UAH-CRW/deploymentboard/README.md

# deploymentboard
Deployment electronics design
