UAH-CRW/deploymentboard/Solenoid extension comparison.PNG

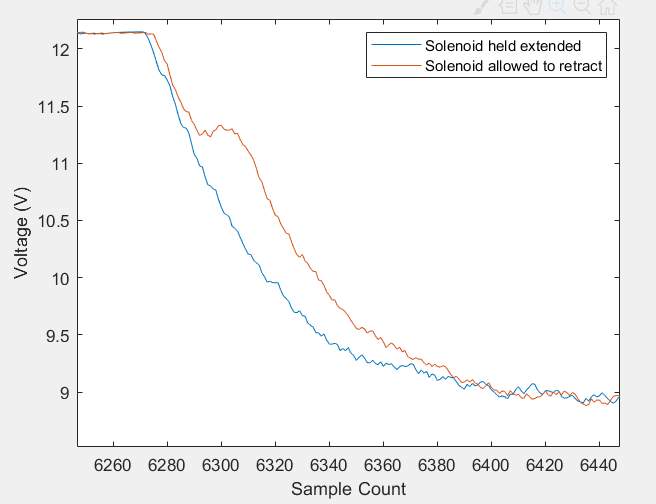
Solenoid extension comparison.PNG
