UAH-CRW/deploymentboard/board/Deployment Board Order Rev2.xlsx

Purchase Order Check List
Date: | 2019-02-14 |  | Vendor: | Digikey
Requestor: | Daniel Corey |  | Contact: | N/A
Account: |  |  | Address: | N/A
Phone (Requestor): | 571-275-3697
Email (Requestor): | dc0069@uah.edu |  | Phone (Vendor): | N/A
 |  |  | Fax (Vendor): | N/A
Quote Attached | ( )
Quote #: |  | Items over $7,500 must be bid out.
Quantity | Part Number | Description and Research Justification |  |  | Unit Price | Total
6 | ED10561-ND | TERM BLK 2P SIDE ENT 2.54MM PCB |  |  | $0.94 | $5.64 | https://www.digikey.com/short/p3rv30 | All components can also be found in the digikey cart linked to the left
3 | 1655-1530-1-ND | DIODE GEN PURP 600V 5A SMB |  |  | $0.53 | $1.59
2 | 563-1003-1-ND | SWITCH SLIDE DIP SPST 100MA 6V |  |  | $1.07 | $2.14
6 | S5902-10-ND | CONN HDR 10POS 0.079 GOLD SMD |  |  | $1.24 | $7.44
4 | 478-1171-1-ND | CAP CER 47PF 50V C0G/NP0 0603 |  |  | $0.10 | $0.40
10 | A130087CT-ND | CRGCQ 0603 220R 5% |  |  | $0.02 | $0.23
16 | SSM3K339RLFCT-ND | MOSFET N-CH 40V 2A SOT-23F |  |  | $0.37 | $5.94
3 | 668-1470-ND | AUDIO MAGNETIC XDCR 3-7V TH |  |  | $0.60 | $1.80
10 | 1276-1784-1-ND | CAP CER 4.7UF 16V X5R 0603 |  |  | $0.21 | $2.10
4 | 311-1060-1-ND | CAP CER 15PF 50V C0G/NPO 0603 |  |  | $0.10 | $0.40
12 | 1276-6524-1-ND | CAP CER 1UF 16V X7R 0603 |  |  | $0.04 | $0.52
4 | 1276-7076-1-ND | CAP CER 22UF 16V X5R 0603 |  |  | $0.87 | $3.48
6 | 641-1698-1-ND | DIODE SCHOTTKY 40V 2A DO214AC |  |  | $0.53 | $3.18
4 | 587-2421-1-ND | FIXED IND 10UH 540MA 133 MOHM |  |  | $0.21 | $0.84
4 | 490-10594-1-ND | FIXED IND 4.7UH 1.4A 180 MOHM |  |  | $0.45 | $1.80
4 | 445-16534-1-ND | FIXED IND 27NH 450MA 220 MOHM |  |  | $0.28 | $1.12
4 | 511-1578-1-ND | LED GREEN DIFFUSED 0603 SMD |  |  | $0.34 | $1.36
4 | 511-1301-1-ND | LED RED CLEAR 0603 SMD |  |  | $0.41 | $1.64
4 | P49.9KDBCT-ND | RES SMD 49.9KOHM 0.1% 1/10W 0603 |  |  | $0.35 | $1.40
10 | 311-432KHRCT-ND | RES SMD 432K OHM 1% 1/10W 0603 |  |  | $0.02 | $0.24
10 | 311-47KGRCT-ND | RES SMD 47K OHM 5% 1/10W 0603 |  |  | $0.02 | $0.20
5 | 296-27024-1-ND | IC REG BCK 3.3V 0.8A SYNC 10MSOP |  |  | $1.93 | $9.65
6 | 36-1051-ND | BATTERY HOLDER CR123A PC PIN |  |  | $1.55 | $9.30
3 | SC4503TSKCT-ND | IC REG BOOST ADJ 1.4A TSOT23-5 |  |  | $1.88 | $5.64
4 | ATXMEGA32A4U-AURCT-ND | IC MCU 8/16BIT 32KB FLASH 44TQFP |  |  | $3.02 | $12.08
4 | EG4544-ND | SWITCH SNAP ACTION SPDT 5A 125V |  |  | $1.23 | $4.92
36 | RR08P10.0KDCT-ND | RES SMD 10K OHM 0.5% 1/16W 0603 |  |  | $0.10 | $3.60
28 | 399-1100-1-ND | CAP CER 0.1UF 25V Y5V 0603 |  |  | $0.04 | $1.01
12 | WM3443-ND | CONN HEADER VERT 2POS 2MM |  |  | $0.34 | $4.03
15 | WM4388-ND | CONN RCPT 2CKT 2MM WTB |  |  | $0.18 | $2.77
50 | WM3454CT-ND | CONN SOCKET 22-28AWG CRIMP TIN |  |  | $0.06 | $2.97
12 | 587-3238-1-ND | CAP CER 10UF 16V X5R 0603 |  |  | $0.32 | $3.82
4 | S9015E-03-ND | CONN HEADER VERT 6POS 1.27MM |  |  | $0.48 | $1.92
5 | DMG2305UX-13DICT-ND | MOSFET P-CH 20V 4.2A SOT23 |  |  | $0.45 | $2.25
12 | 565-4315-ND‎ | CAP ALUM POLY 2200UF 20% 16V T/H |  |  | $1.17 | $14.00
3 | 160-1969-ND‎ | LED RED DIFFUSED T-1 3/4 T/H |  |  | $0.36 | $1.08
3 | CF14JT1K00CT-ND‎ | RES 1K OHM 1/4W 5% AXIAL |  |  | $0.10 | $0.30
2 | 1568-1592-ND‎ | SOLENOID PUSH INTERMITTENT 5V |  |  | $4.95 | $9.90
 |  | Total Price: |  |  |  | $132.70
Daniel Corey
Requestor |  |  | P.I. Appoval
 |  |  | Date
Office Use Only
Requisition #: |  |  | Date:
Purchase Order #: |  |  | Date:
Delivery Date:
Attach backup matter to this form. |  |  |  |  | Rev. 03
