UAH-CRW/deploymentboard/board/BOM with links.xlsx

Id | Designator | Package | Quantity | Designation | Supplier and ref
1 | J1,J3 | 2 pin 2.54mm screw terminal OSTVN02A150 | 2 | Screw_Terminal_01x02 | https://www.digikey.com/product-detail/en/on-shore-technology-inc/OSTVN02A150/ED10561-ND/1588862
2 | C20,C19,C3,C2,C1,C15,C13 | C_0603_1608Metric_Pad1.05x0.95mm_HandSolder | 7 | 100nF | https://www.digikey.com/product-detail/en/samsung-electro-mechanics/CL10B104KO8NNNC/1276-1005-1-ND/3889091
3 | J6 | JST_PH_B2B-PH-K_1x02_P2.00mm_Vertical | 1 | Conn_01x02_Male | https://www.digikey.com/product-detail/en/jst-sales-america-inc/B2B-PH-K-S-LF-SN/455-1704-ND/926611
4 | D4 | D_SMB_Handsoldering | 1 | D_Small | https://www.digikey.com/product-detail/en/smc-diode-solutions/SD560BTR/1655-1530-1-ND/6022975
5 | R17,R14,R7,R13,R6,R4,R2,R1,R5,R10 | R_0603_1608Metric_Pad1.05x0.95mm_HandSolder | 9 | 10k | https://www.digikey.com/product-detail/en/susumu/RR0816P-103-D/RR08P10.0KDCT-ND/432748
6 | SW3 | DIP Switch CHS-01TA | 1 | SW_DIP_x01 | https://www.digikey.com/product-detail/en/nidec-copal-electronics/CHS-01TA/563-1003-2-ND/948314
7 | SW2 | JST_PH_B2B-PH-K_1x02_P2.00mm_Vertical | 1 | SW_SPDT | https://www.digikey.com/product-detail/en/jst-sales-america-inc/B2B-PH-K-S-LF-SN/455-1704-ND/926611
8 | U1 | XBee_SMD | 2 | XBee | https://www.digikey.com/product-detail/en/sullins-connector-solutions/NPPN101BFLD-RC/S5902-10-ND/810025
9 | C17,C18,C7 | C_0603_1608Metric_Pad1.05x0.95mm_HandSolder | 3 | 47pF | https://www.digikey.com/product-detail/en/avx-corporation/06035A470JAT2A/478-1171-1-ND/564203
10 | R15,R16 | R_0603_1608Metric_Pad1.05x0.95mm_HandSolder | 2 | 220 | https://www.digikey.com/product-detail/en/panasonic-electronic-components/ERJ-3EKF22R0V/P22.0HCT-ND/1746745
11 | Q4,Q1,Q2,Q3 | NFET Toshiba SSM3K339R | 4 | Q_NJFET_GSD | https://www.digikey.com/product-detail/en/toshiba-semiconductor-and-storage/SSM3K339RLF/SSM3K339RLFCT-ND/4781038
12 | J5 | PinHeader_2x03_P1.27mm_Vertical | 1 | Conn_02x03_Odd_Even | https://www.digikey.com/product-detail/en/sullins-connector-solutions/GRPB032MWCN-RC/S9017E-03-ND/1786480
13 | BZ1 | Buzzer_12x9.5RM7.6 | 1 | Buzzer | https://www.digikey.com/product-detail/en/pui-audio-inc/AT-1224-TWT-5V-2-R/668-1470-ND/5011404
14 | C10,C8,C5 | C_0603_1608Metric_Pad1.05x0.95mm_HandSolder | 3 | 10uF | https://www.digikey.com/product-detail/en/samsung-electro-mechanics/CL10A106MA8NRNC/1276-1869-1-ND/3889955
15 | C4,C16 | C_0603_1608Metric_Pad1.05x0.95mm_HandSolder | 2 | 4.7uF | https://www.digikey.com/product-detail/en/samsung-electro-mechanics/CL10A475KO8NNNC/1276-1784-1-ND/3889870
16 | C14 | C_0603_1608Metric_Pad1.05x0.95mm_HandSolder | 1 | 15pF | https://www.digikey.com/product-detail/en/yageo/CC0603JRNPO9BN150/311-1060-1-ND/302970
17 | C12 | C_0603_1608Metric_Pad1.05x0.95mm_HandSolder | 1 | 1uF | https://www.digikey.com/product-detail/en/samsung-electro-mechanics/CL10B105MO8NNWC/1276-6524-1-ND/5961383
18 | C11,C6 | C_0603_1608Metric_Pad1.05x0.95mm_HandSolder | 2 | 1uF | https://www.digikey.com/product-detail/en/samsung-electro-mechanics/CL10B105MO8NNWC/1276-6524-1-ND/5961383
19 | C9 | C_0603_1608Metric_Pad1.05x0.95mm_HandSolder | 1 | 22uF | https://www.digikey.com/product-detail/en/samsung-electro-mechanics/CL10A226MO7JZNC/1276-7076-1-ND/7320718
20 | SW1 | JST_EH_B03B-EH-A_1x03_P2.50mm_Vertical | 1 | SW_SPDT | https://www.digikey.com/product-detail/en/jst-sales-america-inc/B3B-PH-K-S-LF-SN/455-1705-ND/926612
21 | J2 | USB_Micro-B_Amphenol_10103594-0001LF_Horizontal | 1 | USB_B_Micro | https://www.digikey.com/product-detail/en/molex-llc/1051640001/WM11263CT-ND/5287250
22 | D3 | D_SOD-323 | 1 | D | https://www.digikey.com/product-detail/en/vishay-semiconductor-diodes-division/10BQ015/10BQ015-ND/351865
23 | L1 | L_1210_3225Metric_Pad1.42x2.65mm_HandSolder | 1 | 10uH | https://www.digikey.com/product-detail/en/taiyo-yuden/LBC3225T100KR/587-2421-1-ND/2230287
24 | L2 | L_1210_3225Metric_Pad1.42x2.65mm_HandSolder | 1 | 4.7uH | https://www.digikey.com/product-detail/en/murata-electronics-north-america/1277AS-H-4R7M=P2/490-10594-2-ND/5247205
25 | L3 | L_1210_3225Metric_Pad1.42x2.65mm_HandSolder | 1 | 27nH | https://www.digikey.com/product-detail/en/tdk-corporation/NLV32T-027J-EF/445-16534-1-ND/4766575
26 | D1 | LED_0603_1608Metric_Pad1.05x0.95mm_HandSolder | 1 | LED - green | https://www.digikey.com/product-detail/en/rohm-semiconductor/SML-D12M8WT86/511-1578-1-ND/1641810
27 | D2 | LED_0603_1608Metric_Pad1.05x0.95mm_HandSolder | 1 | LED - red | https://www.digikey.com/product-detail/en/rohm-semiconductor/SML-310VTT86/511-1301-1-ND/637114
28 | U3 | SSOP-16_3.9x4.9mm_P0.635mm | 1 | FT230XS | https://www.digikey.com/product-detail/en/ftdi-future-technology-devices-international-ltd/FT230XS-R/768-1135-1-ND/3029155
29 | R12 | R_0603_1608Metric_Pad1.05x0.95mm_HandSolder | 1 | 49.9k | https://www.digikey.com/product-detail/en/panasonic-electronic-components/ERA-3AEB4992V/P49.9KDBCT-ND/3075986
30 | R11 | R_0603_1608Metric_Pad1.05x0.95mm_HandSolder | 1 | 432k | https://www.digikey.com/product-detail/en/yageo/RC0603FR-07432KL/311-432KHRCT-ND/730186
31 | R9,R8 | R_0603_1608Metric_Pad1.05x0.95mm_HandSolder | 2 | 27 | https://www.digikey.com/product-detail/en/rohm-semiconductor/ESR03EZPJ270/RHM27DCT-ND/4053754
32 | R3 | R_0603_1608Metric_Pad1.05x0.95mm_HandSolder | 1 | 47k | https://www.digikey.com/product-detail/en/yageo/RC0603JR-0747KL/311-47KGRCT-ND/729741
33 | U4 | 10-pin FP TPS62056DGSR | 1 | IC_REG_BCK_3.3V | https://www.digikey.com/product-detail/en/texas-instruments/TPS62056DGSR/296-27024-1-ND/2255304
34 | BT1,BT2 | CR123A Battery Holder | 2 | Battery | https://www.digikey.com/product-detail/en/keystone-electronics/1051/36-1051-ND/3465420
35 | U5 | IC REG BOOST SC4503TSKTRT | 1 | IC_REG_BOOST_ADJ_1.4A | https://www.digikey.com/product-detail/en/semtech-corporation/SC4503TSKTRT/SC4503TSKCT-ND/1249536
36 | U2 | TQFP-44_10x10mm_P0.8mm | 1 | ATxmega128A4U-AU | https://www.digikey.com/product-detail/en/microchip-technology/ATXMEGA32A4U-AUR/ATXMEGA32A4U-AURCT-ND/3903783
 |  |  |  | Actual arming switch | https://www.digikey.com/product-detail/en/omron-electronics-inc-emc-div/D3V-162-1C5/D3V-162-1C5-ND/2754900
 |  |  |  | Actual latch state switch | https://www.digikey.com/product-detail/en/e-switch/MS0850503F010S1A/EG4544-ND/1628281
 | JST Connectors on cable (01x02) |  |  |  | https://www.amazon.com/Shappy-Pieces-Connector-Silicone-Female/dp/B07449V33P
 | JST connectors on cable (01x03) |  |  |  | https://www.amazon.com/Micro-Connector-150mm-Cable-Female/dp/B01DUC1PW6
