UAH-CRW/deploymentboard/board/board.kicad_pcb

## KiCad design board/board.kicad_pcb (2019-03-03)

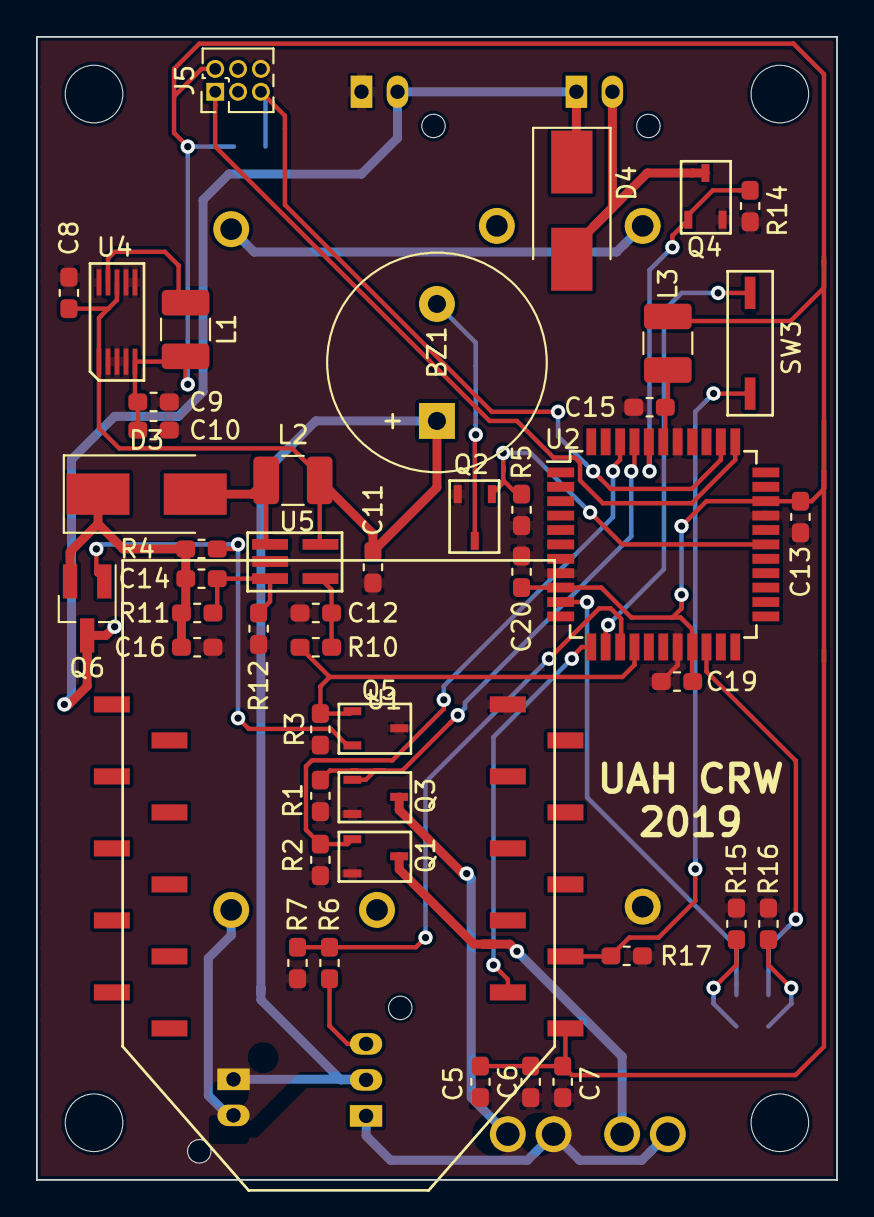
[picture p2: board board.kicad_pcb from above]

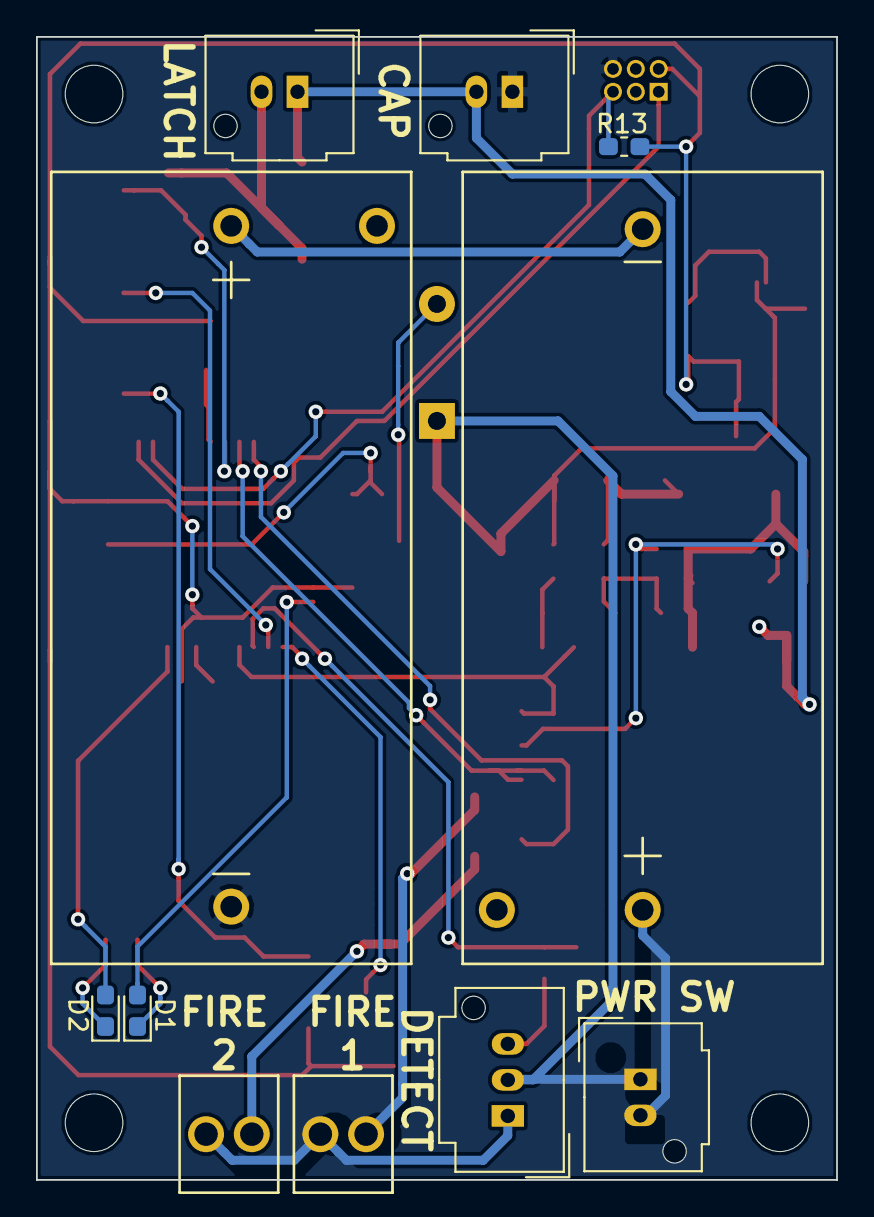
[picture p3: board board.kicad_pcb from below]

Board: 2 copper layers, 44.4 x 63.5 mm, 61 parts (11 on the bottom side), 34 nets.

Parts:
BT1, BT2: Battery; CR123A Battery Holder
BZ1: Buzzer; Buzzer_12x9.5RM7.6
C5, C8, C10: 10uF; C_0603_1608Metric_Pad1.05x0.95mm_HandSolder
C6, C11, C12: 1uF; C_0603_1608Metric_Pad1.05x0.95mm_HandSolder
C7: 47pF; C_0603_1608Metric_Pad1.05x0.95mm_HandSolder
C9: 22uF; C_0603_1608Metric_Pad1.05x0.95mm_HandSolder
C13, C15, C19, C20: 100nF; C_0603_1608Metric_Pad1.05x0.95mm_HandSolder
C14: 15pF; C_0603_1608Metric_Pad1.05x0.95mm_HandSolder
C16: 4.7uF; C_0603_1608Metric_Pad1.05x0.95mm_HandSolder
D1, D2: LED; LED_0603_1608Metric_Pad1.05x0.95mm_HandSolder
D3: D; D_SMB_Handsoldering
D4: D_Small; D_SMB_Handsoldering
J1, J3: Screw_Terminal_01x02; 2 pin 2.54mm screw terminal OSTVN02A150
J4, J6: Conn_01x02_Male; Molex_MicroClasp_55932-0210_1x02_P2.00mm_Vertical
J5: Conn_02x03_Odd_Even; PinHeader_2x03_P1.27mm_Vertical
L1: 10uH; L_1210_3225Metric_Pad1.42x2.65mm_HandSolder
L2: 4.7uH; L_1210_3225Metric_Pad1.42x2.65mm_HandSolder
L3: 27nH; L_1210_3225Metric_Pad1.42x2.65mm_HandSolder
MH1, MH2, MH3, MH4: MountingHole; MountingHole_3.2mm_M3
Q1, Q2, Q3, Q4, Q5: Q_NJFET_GSD; NFET Toshiba SSM3K339R
Q6: Q_PJFET_GSD; SOT-23_Handsoldering
R1, R2, R4, R5, R6, R7, R10, R13, R14, R17: 10k; R_0603_1608Metric_Pad1.05x0.95mm_HandSolder
R3: 10K; R_0603_1608Metric_Pad1.05x0.95mm_HandSolder
R11: 432k; R_0603_1608Metric_Pad1.05x0.95mm_HandSolder
R12: 49.9k; R_0603_1608Metric_Pad1.05x0.95mm_HandSolder
R15, R16: 220; R_0603_1608Metric_Pad1.05x0.95mm_HandSolder
SW1: SW_SPDT; Molex_MicroClasp_55932-0310_1x03_P2.00mm_Vertical
SW2: SW_SPDT; Molex_MicroClasp_55932-0210_1x02_P2.00mm_Vertical
SW3: SW_DIP_x01; DIP Switch CHS-01TA
U1: XBee; XBee_SMD
U2: ATxmega128A4U-AU; TQFP-44_10x10mm_P0.8mm
U4: IC_REG_BCK_3.3V; 10-pin FP TPS62056DGSR
U5: IC_REG_BOOST_ADJ_1.4A; IC REG BOOST SC4503TSKTRT

Connections:
+3V3: C5.2, C6.2, C7.2, C9.1, C10.1, C13.1, C19.1, C20.1, J5.2, L1.2, L3.1, R13.2, U1.1, U2.9, U2.19, U2.31, U4.5
+6V: BZ1.1, C8.1, C11.2, L2.1, SW1.2, SW2.1, U4.1, U4.8, U5.5
+12V: D4.1, J4.2, J6.1, Q6.3
/BUZZER_CTRL: Q2.1, R5.1, U2.28
/E_Match_Fire_1: Q3.1, R1.2, U2.41
/E_Match_Fire_2: Q1.1, R2.1, U2.42
/LATCH_ENABLE: Q5.1, R3.2, R10.2, U2.15
/LATCH_SENSE: R6.2, R7.2, U2.14
/LED1CTRL: D1.2, U2.10
/LED2CTRL: D2.2, U2.20
/PDI_CLK: J5.5, R13.1, U2.35
/PDI_DATA: J5.1, U2.34
/SOLENOID_CTRL: Q4.1, R14.1, U2.40
/USARTC0_RX: U1.2, U2.12
/USARTC0_TX: SW3.1, U2.13
GND: BT2.2, C5.1, C6.1, C7.1, C8.2, C9.2, C10.2, C11.1, C12.2, C13.2, C15.1, C16.2, C19.2, C20.2, J4.1, J5.6, Q1.2, Q2.2, Q3.2, Q4.2, Q5.3, R1.1, R2.2, R3.1, R5.2, R7.1, R12.2, R14.2, R15.1, R16.1, R17.2, U1.10, U2.8, U2.18, U2.30, U2.38, U4.2, U4.3, U4.4, U4.6, U4.7, U4.10, U5.2
unnamed: BT1.1, SW2.2
unnamed: BT1.2, BT2.1
unnamed: BZ1.2, Q2.3
unnamed: C12.1, R10.1, U5.4
unnamed: C14.1, C16.1, D3.1, Q6.2, R4.2, R11.1
unnamed: C14.2, R11.2, R12.1, U5.3
unnamed: C15.2, L3.2, U2.39
unnamed: D1.1, R15.2
unnamed: D2.1, R16.2
unnamed: D3.2, L2.2, U5.1
unnamed: D4.2, J6.2, Q4.3
unnamed: J1.1, Q3.3
unnamed: J1.2, J3.1, SW1.1
unnamed: J3.2, Q1.3
unnamed: L1.1, U4.9
unnamed: Q5.2, Q6.1, R4.1
unnamed: R6.1, SW1.3
unnamed: R17.1, SW3.2, U1.3
