UAH-CRW/deploymentboard/deploymentsoftware/deploymentsoftware/src/Drivers/timercounter.h

/*
 * timercounter.h
 *
 * Created: 10/4/2018 7:01:22 PM
 *  Author: Daniel
 */ 


#ifndef TIMERCOUNTER_H_
#define TIMERCOUNTER_H_

#include <asf.h>

void TC0_setup(TC0_t* TC, enum sysclk_port_id sysclk_port, uint8_t pins_to_ctrl, bool ctrl_pins);
void TC_config(TC0_t* TC, float freq, float duty);

#endif /* TIMERCOUNTER_H_ */
