UAH-CRW/deploymentboard/(commit log)

2018-10-26 MCU and firing circuits
    [board.kicad_pcb, board.sch]
2018-11-11 Added USB connector and FTDI chip
    [board.sch]
2018-11-12 12V converter
    [board.sch]
2018-11-12 Firing circuits, XBee, indicators
    [board.sch]
2018-11-13 3.3V supply, MCU power connections
    [board.sch]
2018-11-13 Made schematic prettier, changed to 8.5x11 paper
    [board.sch]
2018-11-13 Added PDI port
    [board.sch]
2018-11-14 Footprints for XBee and voltage regulators
    [board.sch]
2018-11-14 Added solenoid for latch
    Because that's important. Whoopsie
    [board.kicad_pcb, board.sch]
2018-11-30 Fixed issues Elena identified in her review
    [board.sch]
2018-12-09 Fixed footprints, major placements
    [board.kicad_pcb, board.sch]
2018-12-09 Finished placement, began routing
    [_saved_board.sch, board.kicad_pcb]
2018-12-10 Routed :)
    [_saved_board.sch, board.kicad_pcb, board.sch]
2018-12-13 Work on BOM (incomplete)
    [BOM with links.xlsx, board.kicad_pcb, board.sch]
2018-12-17 Added component values for soft-start RC filter
    [board.sch]
2019-02-03 Fixed solenoid MOSFET hookup
    [BOM with links.xlsx, UAH_CRW_Deployment_v1.0.kicad_pcb, board.sch]
2019-02-05 Initial software creation
    No testing
    [_saved_board.sch]
2019-02-05 Reverted to having 12V supply
    [_saved_board.sch, board.sch]
2019-02-07 Diode, MOSFET, 3-pin JST plug fixes
    [_saved_board.sch, board.kicad_pcb]
2019-02-07 Fixed buzzer hole spacing
    [_saved_board.sch, board.sch]
2019-02-13 Fixed PCB for rev2
    [board.kicad_pcb, board.sch]
2019-03-03 Software updates for hardware rev2
    [Deployment Board Order Rev2.xlsx, Digikey Deployment Board Order Rev2.xlsx, board.kicad_pcb]
2019-03-12 Trying to detect solenoid extension
    [board.sch]
2019-03-14 Solenoid position detection
